michae6345-crypto/frostbite/assets/exploded.png

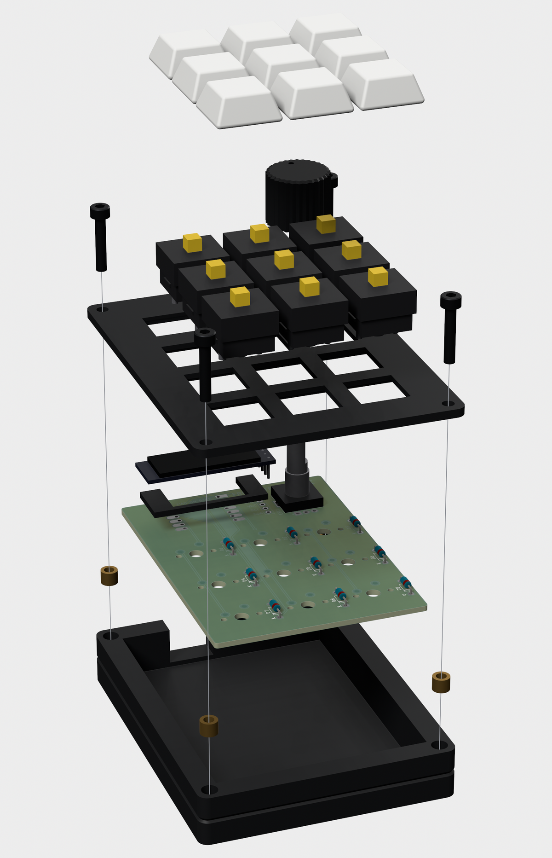
assets/exploded.png
