michae6345-crypto/frostbite/BOM.csv

item | qty | source | link | price_usd | shipping_usd | notes
Seeed XIAO RP2040 | 1 | Hackpad kit | https://hackpad.hackclub.com/parts | 0 | 0 | Free with the kit
MX-style switches | 9 | Hackpad kit | https://hackpad.hackclub.com/parts | 0 | 0 | Free with the kit
White blank DSA keycaps | 9 | Hackpad kit | https://hackpad.hackclub.com/parts | 0 | 0 | Free with the kit
1N4148 through-hole diodes | 9 | Hackpad kit | https://hackpad.hackclub.com/parts | 0 | 0 | Free with the kit
EC11E rotary encoder | 1 | Hackpad kit | https://hackpad.hackclub.com/parts | 0 | 0 | Free with the kit
0.91 inch OLED | 1 | Hackpad kit | https://hackpad.hackclub.com/parts | 0 | 0 | Free with the kit
M3x16 screws | 4 | Hackpad kit | https://hackpad.hackclub.com/parts | 0 | 0 | Free with the kit
M3x5x4 heat-set inserts | 4 | Hackpad kit | https://hackpad.hackclub.com/parts | 0 | 0 | Free with the kit
PCB, 2-layer, 61.15 x 83.15 mm | 1 | JLCPCB | https://jlcpcb.com | 10 | 0 | $10 PCB grant limit | includes shipping
Printed case: Top, Bottom, OLEDSupport, Knob in black | 1 | Printing Legion | https://hackpad.hackclub.com/submitting | 5 | 0 | $5 case grant limit | includes shipping
