michae6345-crypto/frostbite/CAD/frostbite.step

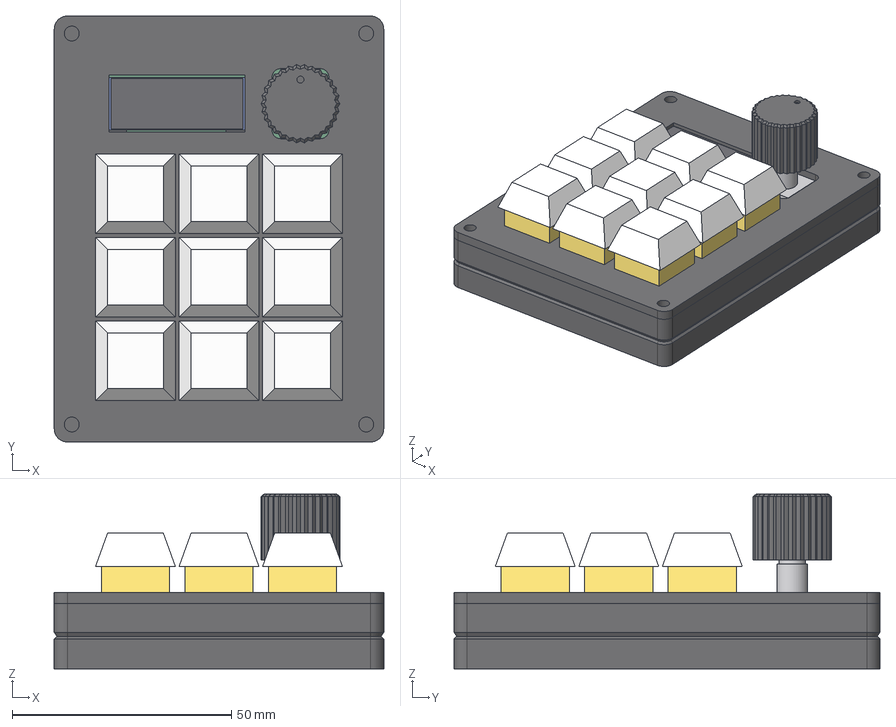
[picture p6: CAD file, 2026-11-05]
CAD/frostbite.step
75.2 x 97.2 x 39.9 mm
Top
Bottom
Knob
OLEDSupport
PCB
SW1_switch
SW1_pins
SW1_keycap
SW2_switch
SW2_pins
SW2_keycap
SW3_switch
SW3_pins
SW3_keycap
SW4_switch
SW4_pins
SW4_keycap
SW5_switch
SW5_pins
SW5_keycap
SW6_switch
SW6_pins
SW6_keycap
SW7_switch
SW7_pins
SW7_keycap
SW8_switch
SW8_pins
SW8_keycap
SW9_switch
SW9_pins
SW9_keycap
OLED_pins
OLED_board
OLED_glass
XIAO_board
XIAO_usb
XIAO_shield
EC11_body
EC11_bushing
EC11_shaft
EC11_pins
