michae6345-crypto/frostbite/production/OLEDSupport.step

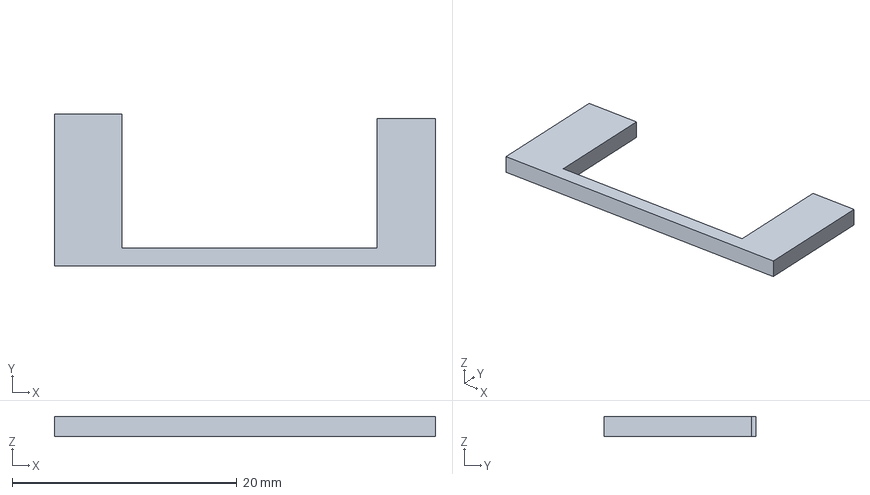
[picture p7: CAD file, 2026-11-05]
production/OLEDSupport.step
33.9 x 13.5 x 1.80 mm
