michae6345-crypto/frostbite/production/Bottom.step

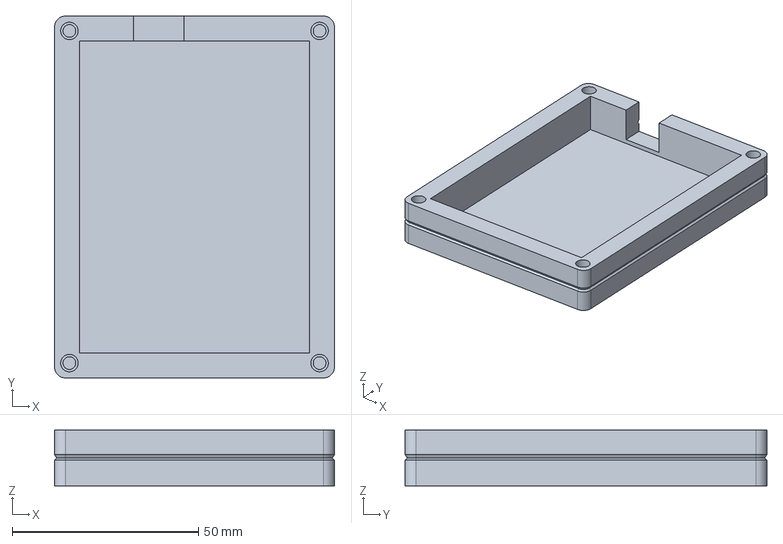
[picture p8: CAD file, 2026-11-05]
production/Bottom.step
75.2 x 97.2 x 14.9 mm
