michae6345-crypto/frostbite/production/Knob.step

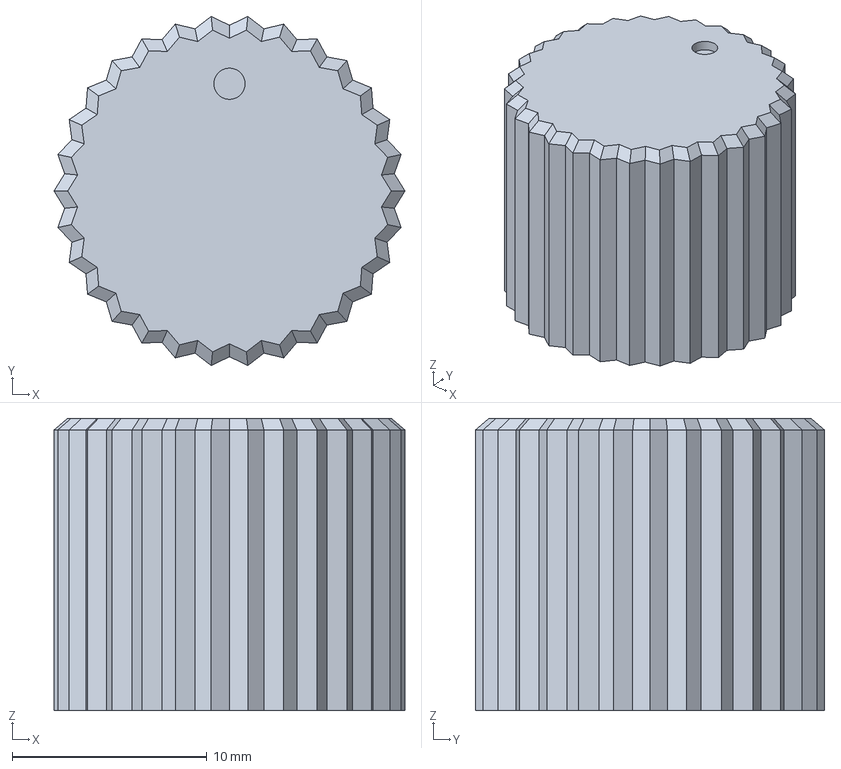
[picture p9: CAD file, 2026-11-05]
production/Knob.step
18.0 x 17.9 x 15.0 mm
