michae6345-crypto/frostbite/production/Top.step

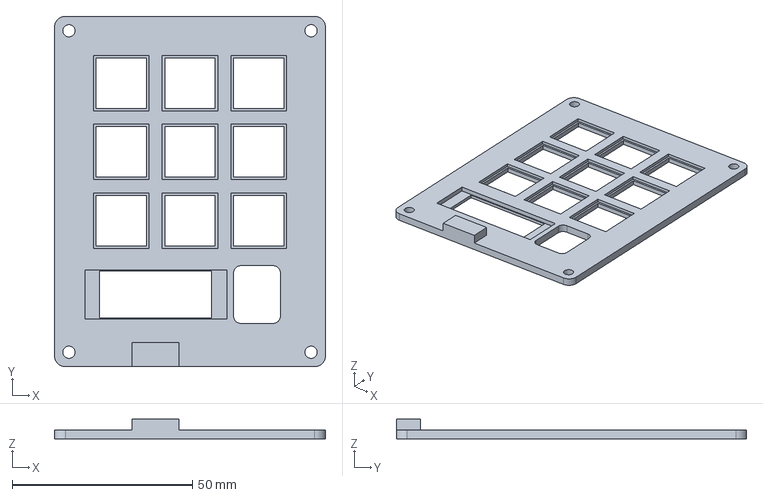
[picture p10: CAD file, 2026-11-05]
production/Top.step
75.2 x 97.2 x 5.43 mm
