michae6345-crypto/frostbite/(list of files, cad)

Other CAD files:
production/Bottom.stl
production/Knob.stl
production/OLEDSupport.stl
production/Top.stl
