michae6345-crypto/frostbite/PCB/frostbite.kicad_pcb

## KiCad design PCB/frostbite.kicad_pcb (2026-11-05)

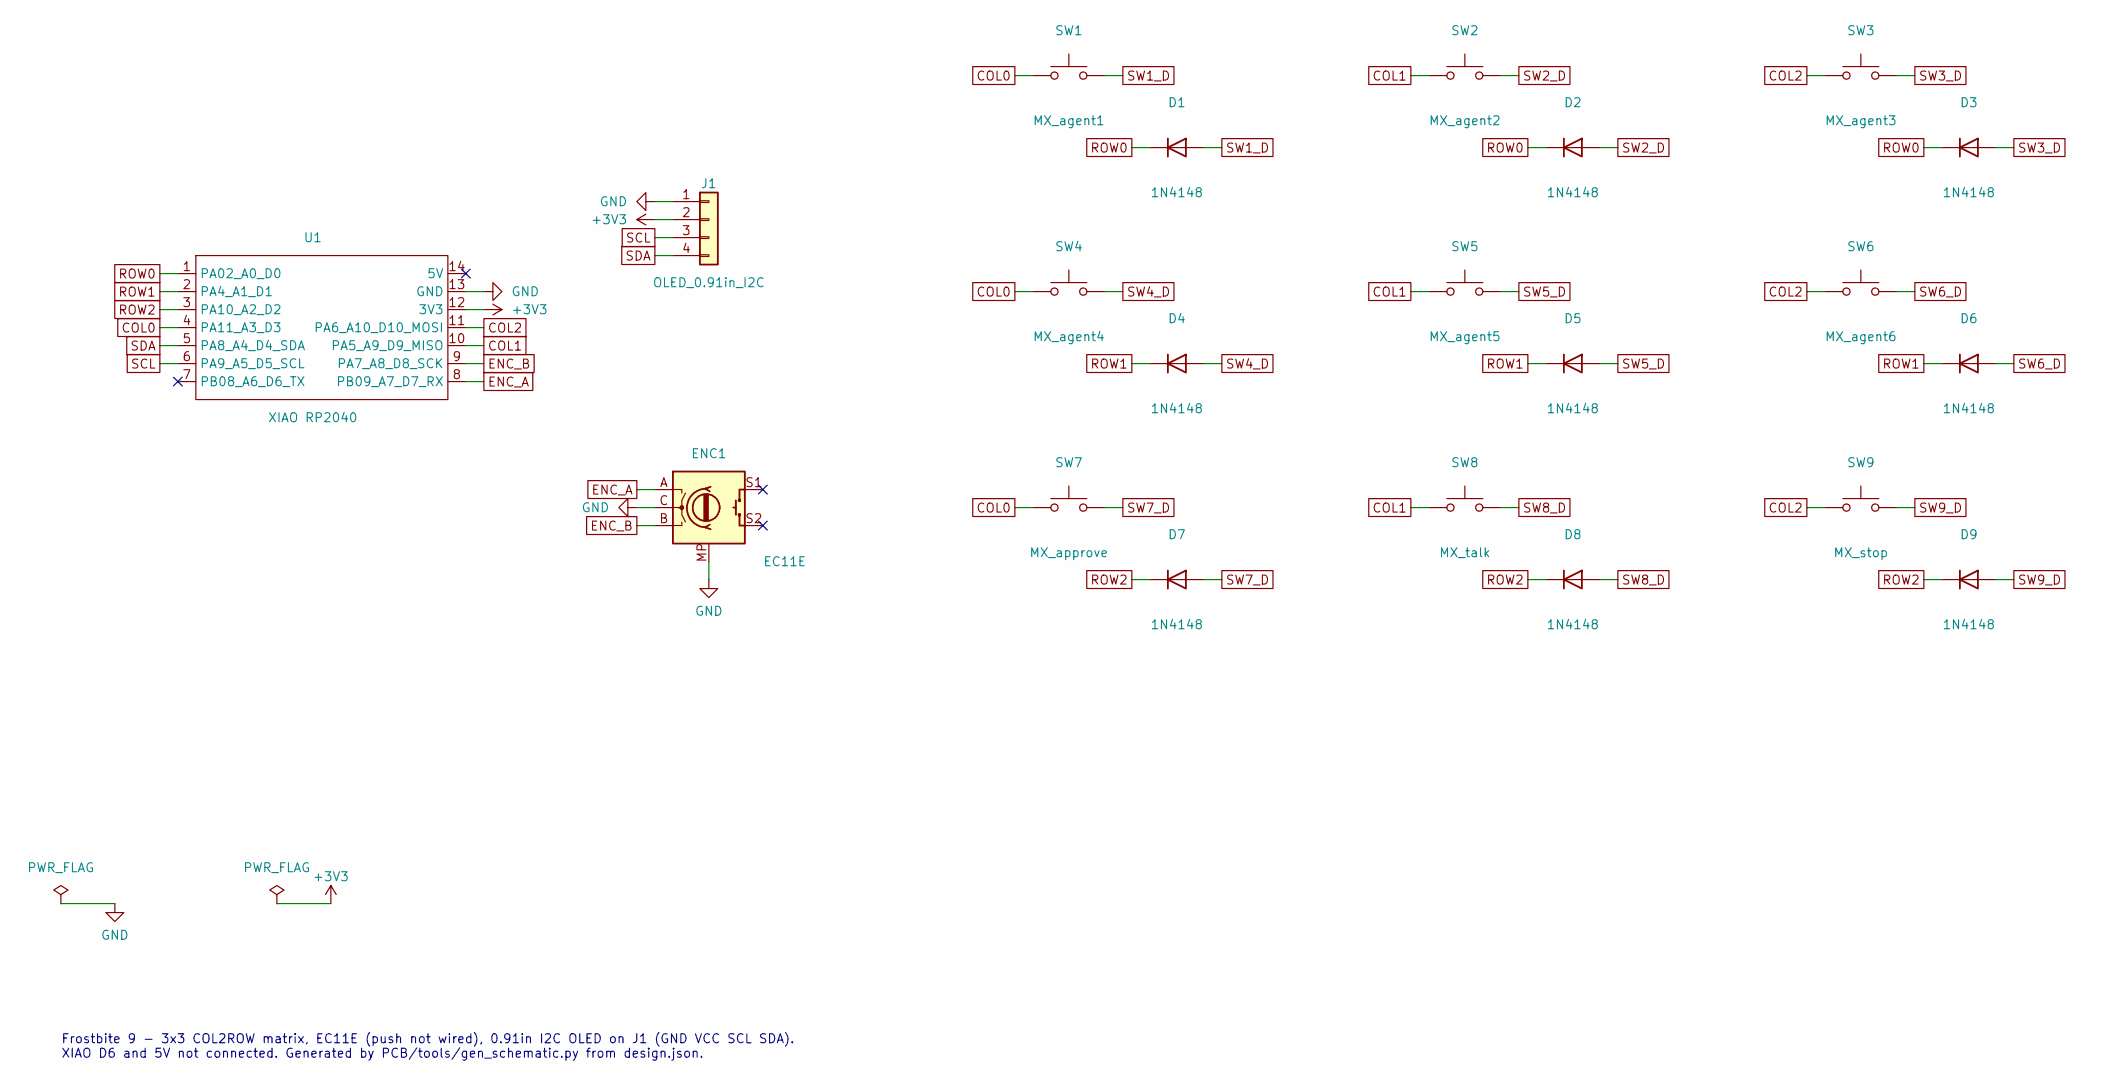
[picture p11: schematic frostbite.kicad_sch, Frostbite 9]

Parts:
D1, D2, D3, D4, D5, D6, D7, D8, D9: 1N4148; D_DO-35_SOD27_P7.62mm_Horizontal
ENC1: EC11E; EC11E-Switch_Vertical_H20mm_Slot3.4x1.5
J1: OLED_0.91in_I2C; PinHeader_1x04_P2.54mm_Vertical
SW1: MX_agent1; MX-Solderable-1U
SW2: MX_agent2; MX-Solderable-1U
SW3: MX_agent3; MX-Solderable-1U
SW4: MX_agent4; MX-Solderable-1U
SW5: MX_agent5; MX-Solderable-1U
SW6: MX_agent6; MX-Solderable-1U
SW7: MX_approve; MX-Solderable-1U
SW8: MX_talk; MX-Solderable-1U
SW9: MX_stop; MX-Solderable-1U
U1: XIAO RP2040; XIAO-Generic-Hybrid-14P-2.54-21X17.8MM

Connections:
+3V3: J1.2, U1.12 (3V3)
COL0: SW1.1, SW4.1, SW7.1, U1.4 (PA11_A3_D3)
COL1: SW2.1, SW5.1, SW8.1, U1.10 (PA5_A9_D9_MISO)
COL2: SW3.1, SW6.1, SW9.1, U1.11 (PA6_A10_D10_MOSI)
ENC_A: ENC1.A, U1.8 (PB09_A7_D7_RX)
ENC_B: ENC1.B, U1.9 (PA7_A8_D8_SCK)
GND: ENC1.C, ENC1.MP, J1.1, U1.13 (GND)
ROW0: D1.1 (K), D2.1 (K), D3.1 (K), U1.1 (PA02_A0_D0)
ROW1: D4.1 (K), D5.1 (K), D6.1 (K), U1.2 (PA4_A1_D1)
ROW2: D7.1 (K), D8.1 (K), D9.1 (K), U1.3 (PA10_A2_D2)
SCL: J1.3, U1.6 (PA9_A5_D5_SCL)
SDA: J1.4, U1.5 (PA8_A4_D4_SDA)
SW1_D: D1.2 (A), SW1.2
SW2_D: D2.2 (A), SW2.2
SW3_D: D3.2 (A), SW3.2
SW4_D: D4.2 (A), SW4.2
SW5_D: D5.2 (A), SW5.2
SW6_D: D6.2 (A), SW6.2
SW7_D: D7.2 (A), SW7.2
SW8_D: D8.2 (A), SW8.2
SW9_D: D9.2 (A), SW9.2

Notes on the sheet:
Frostbite 9 - 3x3 COL2ROW matrix, EC11E (push not wired), 0.91in I2C OLED on J1 (GND VCC SCL SDA). XIAO D6 and 5V not connected. Generated by PCB/tools/gen_schematic.py from design.json.

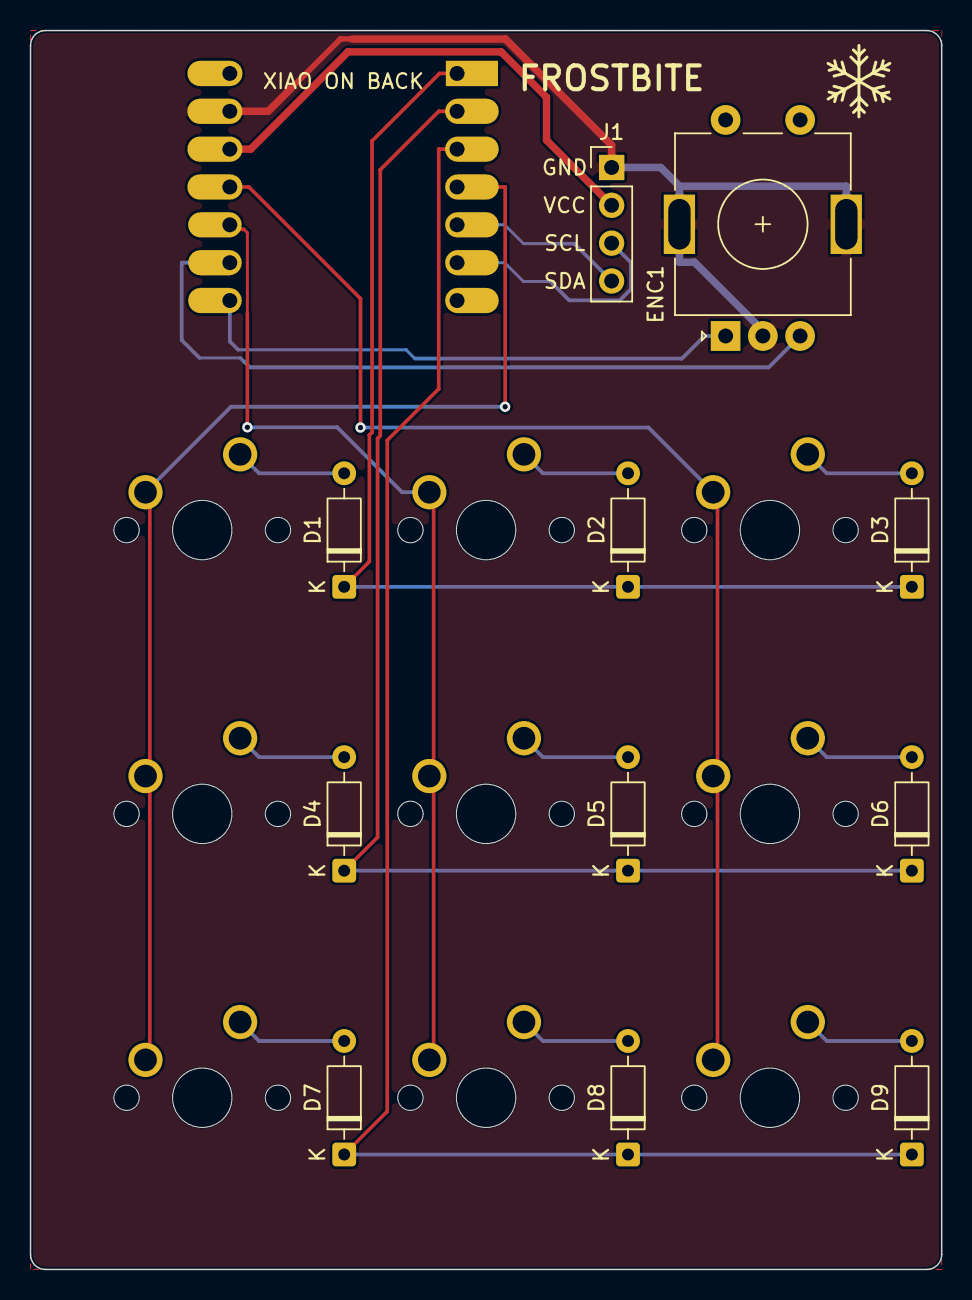
[picture p12: board frostbite.kicad_pcb from above]

Board: 2 copper layers, 61.1 x 83.2 mm, 21 parts (1 on the bottom side), 21 nets.
