michae6345-crypto/frostbite/(commit log)

2026-11-03 Frostbite: Hack Club Hackpad macropad for AI agent and ML training status
    XIAO RP2040, 3x3 keys (6 agent slots + Approve/Talk/Stop), EC11 dial, 0.91in OLED, 13 SK6812 MINI-E.
    - design.json: single source of truth (pins, positions, LED chain, Raw HID protocol)
    - PCB/: KiCad 10 schematic + board generated from design.json; ERC/DRC/parity clean; gerbers
    - CAD/: CadQuery case (Top, GlowBand, Bottom, Knob) + full assembly STEP; fit checks
    - Firmware/: QMK keyboard 'frostbite' (default + ledtest), production UF2s
    - host/: Python companion (Claude Code hooks, training-log watcher)
    - verify/: evidence-based verification with fault-injection self-test
    - studio/: browser design studio for exploring pe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
    [Bottom.step, Bottom.stl, GlowBand.step, GlowBand.stl, Knob.step, Knob.stl, Top.step, Top.stl]
2026-11-03 Fix audit findings: case assembly, OLED, USB safety, soldering
    Six independent audits found what the automated checks could not see.
    - Case: PCB could not pass the screw bosses; shell now 79.15 mm wide, swept assembly checks
    - Firmware: OLED strip never reached the panel, sleep defeated, recovery after PING gaps
    - Host: only opens Frostbite's USB ID (other QMK boards treat PING as a keymap write);
    Approve/Stop require a proved session match; 188 tests
    - PCB: thermal relief on GND pads, marked flipped glow LEDs, EC11 lug slots, J1 labels
    - verify: 31 checks, 45-fault self-test, tests measure function instead of steering shape
    - docs: audits, BOM.csv, generative case concepts; removed the re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
    [BOM.csv, Bottom.step, Bottom.stl, GlowBand.step, GlowBand.stl, Knob.step, Knob.stl, Top.step]
2026-11-04 Add build guide, test print coupons, round 2 audits
    - docs/BUILD.md: first-timer build and bring-up guide (21 file conflicts listed, being resolved)
    - docs/coupons: plate, insert, PCB pocket and glow test prints, 55/55 mesh checks
    - docs/concepts/generative/coupon: Lantern Ribcage wall test
    - docs/audit: second-round hardware and software audits
    [coupon-fence.step, coupon-fence.stl, coupon-wall.step, coupon-wall.stl, coupon1_plate.step, coupon1_plate.stl, coupon2_inserts.step, coupon2_inserts.stl]
2026-11-04 Round 3 fixes: permission-hook Approve, OLED support, doc reconciliation
    - host: Approve answers one exact PermissionRequest hook, no keystrokes; 236 tests
    - CAD: printed OLEDSupport, glass below the plate, real lip gap; 50/50 checks
    - Firmware: USB resume wakes the OLED once, 54 harness checks
    - PCB: 0.20 mm annular ring rule, corrected glow LED notes
    - verify: 32 checks, 57-fault self-test, function tests instead of shape tests,
    stricter JLCPCB rule now gates
    - docs: 21 conflicts resolved in BUILD.md and READMEs
    [BOM.csv, Bottom.step, GlowBand.step, Knob.step, OLEDSupport.step, OLEDSupport.stl, Top.step, Top.stl]
2026-11-04 Switch case to matte black, condense README and docs, tidy code
    Top, Bottom and OLEDSupport are now matte black PETG. GlowBand stays
    clear. Geometry is unchanged. Glow notes cover the light black absorbs.
    README cut from 275 to about 130 lines, with status stated up front and
    the Stop, Approve and macOS limits spelled out. Sub-docs condensed.
    Code lost banners, narration and dead code; firmware binaries are
    byte-identical and no STL changed.
    [BOM.csv, Bottom.step, GlowBand.step, Knob.step, OLEDSupport.step, Top.step, frostbite-assembly.step]
2026-11-04 Fix bugs from the cleanup pass
    Host: glow colour matches the firmware, bad --done-pattern gives a plain
    error, a queued update can't revive an unwatched slot, and repeating
    --name for two logs is refused at startup.
    Tests and verifier: firmware checks that only printed now fail, lib8tion
    compile errors surface, a skipped protocol test is NOT_RUN, a missing
    LAYOUT fails, unmatched project DRC rules fail, and the switch check
    uses a 13.9 mm housing.
    Studio: width now matches the 79.15 mm case, stale dimensions updated,
    inserts drawn in the Top, wordmark off, OLED text matches the firmware.
2026-11-05 Redesign as all-black flat macropad with no LEDs, kit parts only
    Remove all 13 LEDs from the PCB, firmware and laptop script. Status now
    shows on the OLED. The ledtest keymap becomes bringup.
    Replace the floating shell and glow band with a flat sandwich case:
    Top plate, Bottom tray, OLEDSupport and Knob, all black, with M3x16
    screws from the top into inserts in the Bottom.
    Cut the BOM to kit parts plus the PCB and printed case. Rewrite the
    README to the Hackpad and Stardance checklists. Update the build guide
    and verifier for the new design.
    [BOM.csv, Bottom.step, Bottom.stl, GlowBand.step, GlowBand.stl, Knob.step, OLEDSupport.step, OLEDSupport.stl]
2026-11-05 Clean out the repo, keep only the final design
    Remove old concepts, audits, test tooling and generator scripts. Flatten
    the firmware, move images to assets/, make the case script self-contained
    and cut comments down.
    [BOM.csv, coupon-fence.step, coupon-fence.stl, coupon-wall.step, coupon-wall.stl, coupon1_plate.step, coupon1_plate.stl, coupon2_inserts.step]
2026-11-08 Rewrite README with protocol, pin map and build steps (#1)
    * Rewrite README with protocol, pin map and build steps
    Describe the firmware's keyboard and host modes, the raw HID report
    format, and the Python host. Add a wiring and build section and a repo
    layout. State that the image is a CAD render and that the repo does not
    document a built or tested board.
    * Fix README details found in a claim check
    ---------
